fablabnbg/EspWebServo/esp12e-boot-modes.jpg

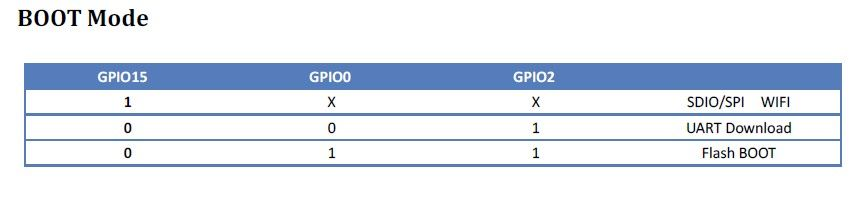
esp12e-boot-modes.jpg
