fablabnbg/EspWebServo/photos/proto-assembly.jpg

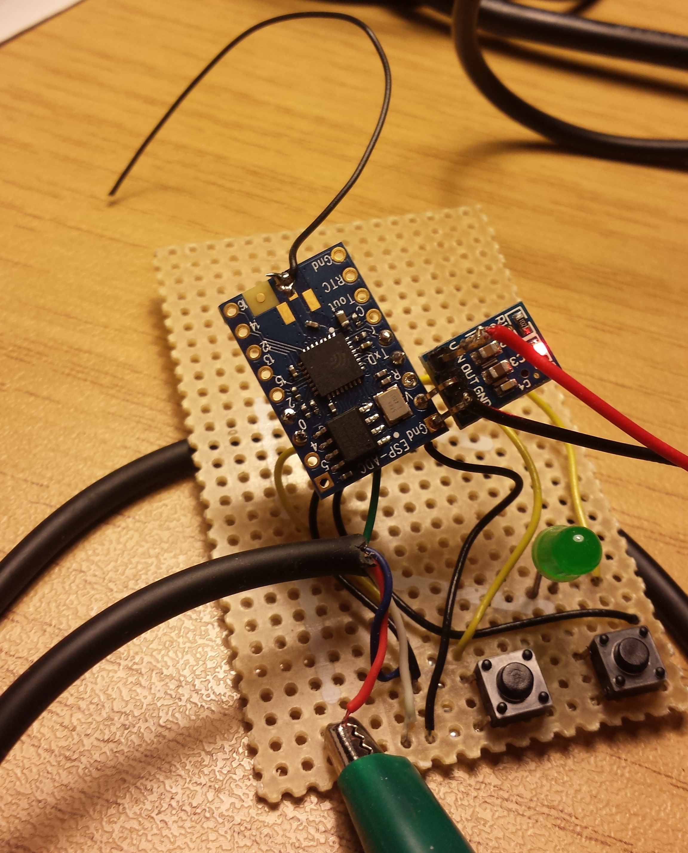
photos/proto-assembly.jpg
