fablabnbg/EspWebServo/slider.html.h

unsigned char slider_html[] = {
  0x3c, 0x21, 0x64, 0x6f, 0x63, 0x74, 0x79, 0x70, 0x65, 0x20, 0x68, 0x74,
  0x6d, 0x6c, 0x3e, 0x0a, 0x3c, 0x68, 0x74, 0x6d, 0x6c, 0x3e, 0x0a, 0x3c,
  0x68, 0x65, 0x61, 0x64, 0x3e, 0x3c, 0x6d, 0x65, 0x74, 0x61, 0x20, 0x63,
  0x68, 0x61, 0x72, 0x73, 0x65, 0x74, 0x3d, 0x22, 0x75, 0x74, 0x66, 0x2d,
  0x38, 0x22, 0x20, 0x2f, 0x3e, 0x3c, 0x2f, 0x68, 0x65, 0x61, 0x64, 0x3e,
  0x0a, 0x3c, 0x62, 0x6f, 0x64, 0x79, 0x3e, 0x0a, 0x3c, 0x69, 0x6e, 0x70,
  0x75, 0x74, 0x20, 0x69, 0x64, 0x3d, 0x22, 0x73, 0x65, 0x72, 0x76, 0x6f,
  0x31, 0x22, 0x20, 0x74, 0x79, 0x70, 0x65, 0x20, 0x3d, 0x22, 0x72, 0x61,
  0x6e, 0x67, 0x65, 0x22, 0x20, 0x6f, 0x6e, 0x6b, 0x65, 0x79, 0x75, 0x70,
  0x3d, 0x22, 0x73, 0x65, 0x6e, 0x64, 0x56, 0x61, 0x6c, 0x75, 0x65, 0x28,
  0x27, 0x73, 0x65, 0x72, 0x76, 0x6f, 0x31, 0x27, 0x2c, 0x20, 0x27, 0x73,
  0x65, 0x72, 0x76, 0x6f, 0x31, 0x5f, 0x6c, 0x61, 0x62, 0x65, 0x6c, 0x27,
  0x29, 0x22, 0x20, 0x6f, 0x6e, 0x63, 0x68, 0x61, 0x6e, 0x67, 0x65, 0x3d,
  0x22, 0x73, 0x65, 0x6e, 0x64, 0x56, 0x61, 0x6c, 0x75, 0x65, 0x28, 0x27,
  0x73, 0x65, 0x72, 0x76, 0x6f, 0x31, 0x27, 0x2c, 0x27, 0x73, 0x65, 0x72,
  0x76, 0x6f, 0x31, 0x5f, 0x6c, 0x61, 0x62, 0x65, 0x6c, 0x27, 0x29, 0x22,
  0x20, 0x6d, 0x69, 0x6e, 0x3d, 0x22, 0x30, 0x22, 0x20, 0x6d, 0x61, 0x78,
  0x3d, 0x22, 0x31, 0x38, 0x30, 0x22, 0x20, 0x73, 0x74, 0x65, 0x70, 0x3d,
  0x22, 0x35, 0x22, 0x20, 0x76, 0x61, 0x6c, 0x75, 0x65, 0x3d, 0x22, 0x39,
  0x30, 0x22, 0x2f, 0x3e, 0x0a, 0x3c, 0x69, 0x6e, 0x70, 0x75, 0x74, 0x20,
  0x69, 0x64, 0x3d, 0x22, 0x73, 0x65, 0x72, 0x76, 0x6f, 0x31, 0x5f, 0x6c,
  0x61, 0x62, 0x65, 0x6c, 0x22, 0x20, 0x6f, 0x6e, 0x63, 0x68, 0x61, 0x6e,
  0x67, 0x65, 0x3d, 0x22, 0x73, 0x65, 0x6e, 0x64, 0x56, 0x61, 0x6c, 0x75,
  0x65, 0x28, 0x27, 0x73, 0x65, 0x72, 0x76, 0x6f, 0x31, 0x5f, 0x6c, 0x61,
  0x62, 0x65, 0x6c, 0x27, 0x2c, 0x20, 0x27, 0x73, 0x65, 0x72, 0x76, 0x6f,
  0x31, 0x27, 0x29, 0x22, 0x20, 0x74, 0x79, 0x70, 0x65, 0x3d, 0x22, 0x74,
  0x65, 0x78, 0x74, 0x22, 0x20, 0x73, 0x69, 0x7a, 0x65, 0x3d, 0x22, 0x33,
  0x22, 0x3e, 0x3c, 0x2f, 0x69, 0x6e, 0x70, 0x75, 0x74, 0x3e, 0x0a, 0x3c,
  0x62, 0x72, 0x3e, 0x3c, 0x69, 0x6e, 0x70, 0x75, 0x74, 0x20, 0x69, 0x64,
  0x3d, 0x22, 0x73, 0x65, 0x72, 0x76, 0x6f, 0x31, 0x5f, 0x6c, 0x65, 0x66,
  0x74, 0x22, 0x20, 0x20, 0x6f, 0x6e, 0x63, 0x6c, 0x69, 0x63, 0x6b, 0x3d,
  0x22, 0x63, 0x68, 0x61, 0x6e, 0x67, 0x65, 0x56, 0x61, 0x6c, 0x75, 0x65,
  0x73, 0x28, 0x30, 0x2c, 0x20, 0x30, 0x2c, 0x20, 0x30, 0x2c, 0x20, 0x20,
  0x20, 0x27, 0x73, 0x65, 0x72, 0x76, 0x6f, 0x31, 0x5f, 0x6c, 0x61, 0x62,
  0x65, 0x6c, 0x27, 0x2c, 0x20, 0x27, 0x73, 0x65, 0x72, 0x76, 0x6f, 0x31,
  0x27, 0x29, 0x22, 0x20, 0x74, 0x79, 0x70, 0x65, 0x3d, 0x22, 0x62, 0x75,
  0x74, 0x74, 0x6f, 0x6e, 0x22, 0x20, 0x76, 0x61, 0x6c, 0x75, 0x65, 0x3d,
  0x22, 0x7c, 0x3c, 0x22, 0x3e, 0x3c, 0x2f, 0x69, 0x6e, 0x70, 0x75, 0x74,
  0x3e, 0x0a, 0x3c, 0x69, 0x6e, 0x70, 0x75, 0x74, 0x20, 0x69, 0x64, 0x3d,
  0x22, 0x73, 0x65, 0x72, 0x76, 0x6f, 0x31, 0x5f, 0x6d, 0x69, 0x6e, 0x75,
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
unsigned int slider_html_len = 2637;
