fablabnbg/EspWebServo/(commit log)

2015-12-27 Structured pages
    root no longer auto-refreshes,
    hinted at stats (which do auto-refresh)
    and servo left, center, right as a starter.
    Upload code is at /upload, but does not seem to work. Sigh.
    [EspWebServo.ino]
2015-12-27 admin added, slider added. We are getting fancy now. Changing STA via AP is now coded. Changing the servo with a javascript slider is now coded.
2015-12-27 fixed \0 termination of embedded files.
    [EspWebServo.ino, admin.html.h, slider.html.h]
2015-12-27 small beauty-fixes. web ui tested on android dolphin browser!
    Link to github added. So that people can file issues and contribute.
    [EspWebServo.ino, admin.html.h, slider.html.h]
2015-12-28 Added roboremo support. Added speed settings. Added support for multiple servos.
2015-12-28 station reconfiguration debugged. Works now. FIXME: need a proper CGI unescape for decoding of GET parameters. We currently only do String.replace('+', ' ');
    [EspWebServo.ino, admin.html.h]
2015-12-29 Create 2mm-esp-clamp-svg
2015-12-29 Update 2mm-esp-clamp-svg
    manual copy paste ...
2015-12-30 2x7 pins was wrong, had to fix the protoype with ugly hot glue.
    [EspWebServo.ino]
2015-12-30 clamp widened to 8 pins per row. gahhg. clamp shortened to 80mm this is sufficient. More holes for zip-ties.
2016-01-05 rotated milling plan
2016-01-06 new version of the clamp!
